ethanzamora/microgreens-apparatus/design/HGIV6-pyramid.stl

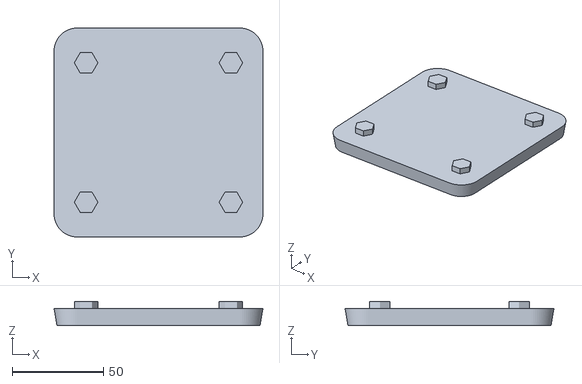
[picture p10: CAD file, 2026-05-28]
design/HGIV6-pyramid.stl
114.3 x 114.3 x 13.3
