ethanzamora/microgreens-apparatus/design/HGIV6.stl

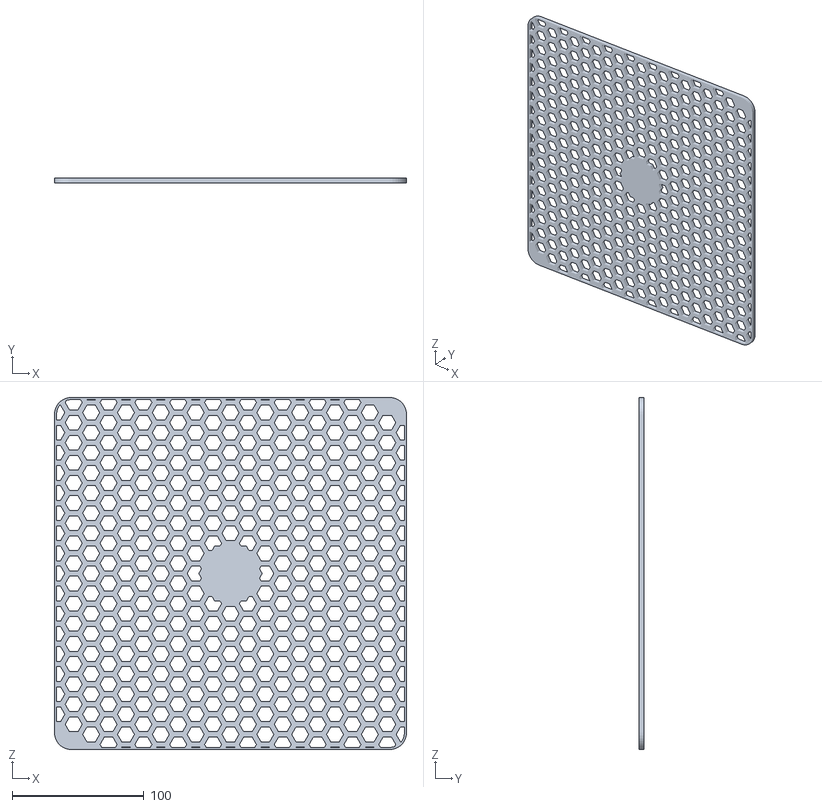
[picture p11: CAD file, 2026-05-28]
design/HGIV6.stl
266.7 x 3.81 x 266.7
